Le-laser/Projet/rapports séances/Lucas Bagrowski/Avancement.md

### 10/09/2020

Prise de connaissance des différents projets <br/>
Choix du sujet -> Laser <br/>
Définition du groupe de travail <br/>
Répartition et définition des tâches <br/>
Choix des premiers actionneurs pour créer une tourelle 2 axes <br/>
Choix du laser pour prototype non dangereux <br/>
<br/> <br/>

### 25/09/2020

Choix des stepmotors Nema17<br/>
Création de la pièce 3D pour réaliser le lien entre les deux Stepmotors<br/>
Étude des ruches mises en place sur le campus <br/>
<br/> <br/>

### 08/10/2020

Fabrication carte électronique pour tourrelle 2 axes Stepmotors avec un PCB à trous <br/>
Création de la pièce 3D pour fixer la diode Laser de Mattéi sur l'axe d'un Stepmotor <br/>
Début du code pour tourelle 2 axes Stepmotors <br/>
<br/> <br/>

### 22/10/2020

Assemblage tourelle 2 axes Stepmotors avec pièce imprimée en 3D <br/>
Ajout de la diode Laser sur la tourelle <br/>
Fin du code tourelle 2 axes Stepmotors <br/>
Premiers tests de pointage laser sur un mur <br/>
<br/> <br/>

### 19/11/2020

Assemblage tourelle servomoteurs donnée par M. Peter <br/>
Début du code tourrelle 2 axes servomoteurs <br/>
Explication du fonctionnement de Kicad à Lucas Sabatier<br/>
<br/> <br/>

### 26/11/2020

Fin du programme servomoteur sur Arduino <br/>
Mesure de la précision des 2 différentes tourelles <br/>
Ré-impréssion de la pièce pour tourrelle Stepmotor, qui a cassé lors du transport <br/>
Création de la pièce 3D pour fixer la diode laser sur l'axe d'un servomoteur <br/>
<br/> <br/>

### 03/12/2020

Discussion concernant l'échange de données entre la partie acquisition d'image et la partie asservissement mécanique <br/>
Début du code d'asservissement sur un axe avec servo moteur <br/>
<br/> <br/>

### 04/12/2020

Fin du code d'asservissement sur un axe avec servo moteur <br/>
Premiers tests avec le clavier utilisé comme entrée d'information <br/>
<br/> <br/>

### 10/12/2020

Modélisation et impression du support Nema17 pour créer la platine fixe de tests <br/>
L'impression s'est mal déroulée, problème de sous extrusion <br/>
Ajout de la partie asservissement avec moteur pas à pas <br/>
<br/> <br/>

### 17/12/2020

Impression nouvelle pièce et assemblage <br/>
<br/> <br/>

### 08/01/2021

Diaporama de présentation du semestre 7 <br/>
<br/> <br/>

### 15/01/2021

Soutenance de mi-parcours <br/>
<br/> <br/>

### 29/01/2021

Début code communication entre les microcontroleurs UART<br/>
<br/> <br/>

### 12/02/2021

Récupération du code de Micha pour faire un prototype à positionner en conditions réelles mais<br/>
nous avons ensuite appris que les frelons ne sortaient pas avant Juin <br/>
<br/> <br/>

### 19/02/2021

Test et fin code communication entre les microcontroleurs <br/>
Création carte de prototypage pour le laser <br/>
<br/> <br/>

### 05/03/2021

Aide Mattéi sur le montage laser <br/>
<br/> <br/>

### 12/03/2021

Test Laser que Mattéi a fait fonctionner correctement sur la tourelle <br/>
<br/> <br/>

### 19/03/2021

Choix des composants <br/>
Import des librairies Kicad <br/>
Début schématique carte <br/>
<br/> <br/>

### 02/04/2021

Encore sur le schématique de la carte <br/>
Problèmes car certains systèmes ne sont pas encore définis <br/>
<br/> <br/>

### 15/04/2021

Préparation de la soutenance <br/>
<br/> <br/>
