Le-laser/Projet/rapports séances/Michael CHATOEV/suivi.md

### 10/09/2020
- Rédaction cahier des charges
- Etablissement d'une architecture système
- Définission des tâches
- Attribution des tâches

### 25/09/2020
- Recherches sur le machine learning
- Choix de l'outil utilisé pour le traitement d'image : tensorflow lite
- Installation Python 3.8.5 sur machine virtuelle linux
- Installation PIP sur machine virtuelle linux

### 08/10/2020
- Création d'une nouvelle VM dédiée à Tf
- Installation Tensorflow
- Installation Docker
- Installation PIP
- Découverte Colaboratory
- Introduction à Tf

### 22/10/2020
- Test de PyTorch : bibliothèque python pour le traitement d'image
- Installation de PyTorch
- Installation de PyCharm : IDE python
- Tutoriels PyTorch

Si PyTorch se trouve être trop compliqué ou ne convient pas à notre utilisation, nous passerons à TensorFlow.

### 19/11/2020
- Etude du contenu du Github https://github.com/Barrois/Detecteur-ESP32-Cam-Blob-Detector
- téléchargement et étude des librairies esp32_camera, esp_timer et arduinoFFT avec V.D. 

### 26/11/2020
- Etude du code du Github récupéré précédemment
- Une partie du code nécessite d'être reprise
- Création d'une fonction de transfert de données (Tx Rx) entre le ESP et un arduino pour envoyer les coordonnées du frelon
- Etude de la librairie JPEGDecoder

### 03/12/2020
- Traitement d'image

### 04/12/2020
- Traitement d'image
- Création code de test

### 26/11/2020
- Traitement d'image
- Création code photo+traitement

### 17/12/2020
- Traitement d'image
- Optimisation temps / espace du code de traitement d'image :
    - Masquage sur les tableaux de bools *gain de 7 bit/pixel
    - Modification de la logique de stockage des variables caractéristiques des tâches, *gain de 3xLEN/5 octets
    - Mesure du temps de traitement de l'image, 300.10^-6 sec pour une image de 50x50

### 08/01/2021
- Création powerpoint présentation de fin de semestre 7
- Création machine à état du système du projet

### 15/01/2021
- Soutenance

### 29/01/2021
- Traitement d'image

### 12/02/2021
- Création code automatisation de création d'images de test

### 19/02/2021
- Test traitement d'image Barrois

### 05/03/2021
- Test Traitement d'image perso

### 12/03/2021
- Optimisation traitement d'image perso

### 19/03/2021
- Reconnaissance frelon au micro

### 02/04/2021
- Code final esp32 reconnaissance frelon au micro + prise photo + envoie en UART

### 15/04/2021
- Création powerpoint présentation de fin de semestre 8
- Préparation soutenance
