Le-laser/Projet/Dossier Lucas/BOM_RucheV1.0.md

| Part Name| Ref| Value| Qtity on card| Qtity to buy| Link|
|-|-|:-:|:-:|:-:|-|
| Batteries Holder| 534-1043| 2 x 18650| 1| ?| [Link](https://www.mouser.fr/ProductDetail/Eagle-Plastic-Devices/12BHC186P-GR/?qs=AQlKX63v8Rv70Ee1H7gwgg%3D%3D)|
| Tension Regulator| 621-AP63300WU-7| Buck| 2| ?| [Link](https://www.mouser.fr/ProductDetail/Diodes-Incorporated/AP63300WU-7/?qs=bZr6mbWTK5nNNXnHDcrFZg%3D%3D)|
| Fusible réarmable| | | | | [Link]()|
| Diode anti inversion| 583-FML340A-W| 40V - 3A| 1| ?| [Link](https://www.mouser.fr/ProductDetail/Rectron/FML340A-W/?qs=5aG0NVq1C4znVqzNSkqGkQ%3D%3D)|
| Arduino Nano| | | | | [Link]()|
| ESP32 CAM| | | | | [Link]()|
| Drivers step motor| A4988| | | | [Link]()|
| Micro| MAX9814| | | | [Link]()|
| | | | | | [Link]()|
