Le-laser/Projet/Rapport de fabrication/READ ME

# Bzz_final : 
projet arduino à téleverser sur l'ESP32-CAM.

  A faire : 
*    Réception message de détection sonor d'un frelon par l'Arduino (UART)
*    Tests
