Le-laser/Projet/Rapport de fabrication/calculateur_composant_buck.xlsx

ILED: | 1 | A
Rsense: | 0.2 | Ohm
Selecting The Off-Time Setting Resistor
VLED: | 5 | V
Vdiode | 1 | V
DCRL: | 0.5 | Ohm
L: | 22 | uH
I ripple: | 100 | mA
tOFF: | 3.384615385e-07 | s
ROT: | 33846.15385 | Ohm
