Le-laser/Projet/Test_Img/img_test_1.txt

21 40 1 26 30 13
67	75	93	237	195	90	90	229	244	139	98	78	220	38	50	116	47	247	252	174	242	236	95	154	8	8	21	111	124	147	81	64	94	46	46	34	136	8	135	253	147	233	76	239	143	254	101	190	246	225	109	
233	206	205	132	86	85	153	197	81	173	23	145	12	70	63	174	78	199	54	76	218	160	153	203	48	24	176	111	15	146	220	248	224	42	252	55	127	22	252	81	195	147	226	208	217	162	254	41	106	53	
244	196	85	14	144	6	38	192	117	53	210	82	173	179	252	42	106	251	65	103	77	0	0	0	0	0	0	0	0	0	0	0	0	0	0	0	0	0	0	132	251	49	212	85	83	211	253	61	137	243	
2	94	2	19	100	168	211	217	93	39	172	12	218	41	181	70	37	118	45	115	251	0	0	0	0	0	0	0	0	0	0	0	0	0	0	0	0	0	0	41	36	80	127	119	37	252	180	46	240	54	
140	115	73	241	28	157	75	121	196	119	5	31	160	59	228	198	177	19	58	45	187	0	0	0	0	0	0	0	0	0	0	0	0	0	0	0	0	0	0	94	126	186	213	163	184	10	209	169	64	94	
156	10	207	184	167	28	178	108	147	55	11	53	114	240	123	164	4	181	209	63	20	0	0	0	0	0	0	0	0	0	0	0	0	0	0	0	0	0	0	80	250	105	115	179	242	69	220	51	36	122	
188	243	178	100	143	228	80	163	156	92	88	15	204	211	51	208	137	6	143	29	86	0	0	0	0	0	0	0	0	0	0	0	0	0	0	0	0	0	0	138	6	202	189	248	143	27	171	51	21	105	
167	199	205	55	45	158	218	201	122	51	88	71	134	140	151	16	18	39	172	104	50	0	0	0	0	0	0	0	0	0	0	0	0	0	0	0	0	0	0	178	178	239	171	194	11	215	245	32	65	157	
104	142	85	21	45	48	94	39	227	182	110	233	194	133	122	212	173	39	189	223	90	0	0	0	0	0	0	0	0	0	0	0	0	0	0	0	0	0	0	239	79	133	178	91	93	169	250	158	198	99	
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
190	114	214	190	35	240	167	25	163	18	24	177	76	225	232	175	200	72	227	66	21	168	190	82	10	87	184	54	97	8	21	32	122	107	95	29	220	134	182	0	152	206	177	101	48	154	21	249	98	120	
187	246	160	122	73	170	210	3	225	179	11	118	211	5	98	178	35	63	58	217	63	82	40	240	183	88	12	76	82	110	196	142	102	102	9	47	144	91	50	241	15	188	232	99	194	75	149	101	10	79	
190	73	162	230	185	90	190	197	167	145	180	108	32	27	82	168	201	99	5	124	212	147	57	189	118	123	136	13	96	146	92	31	219	126	133	22	217	69	91	129	214	16	109	246	170	64	159	117	35	36	
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
