Le-laser/Projet/Test_Img/img_test_2.txt

14 39 10 40 26 25
249	171	221	14	218	233	101	108	220	72	166	34	246	105	193	57	188	26	157	160	80	182	216	27	189	52	226	250	98	59	153	93	230	247	234	66	97	207	174	62	151	85	223	143	63	34	200	251	187	230	157	
12	29	118	40	218	42	138	86	141	197	239	106	173	103	85	111	201	165	30	135	61	115	231	204	50	10	22	47	197	252	76	82	153	66	122	117	109	5	75	250	75	186	228	120	35	185	231	108	95	6	
115	157	248	91	233	44	228	127	218	171	251	39	253	150	105	247	139	86	252	214	208	199	145	181	64	52	112	40	160	79	46	21	236	167	239	87	83	213	214	46	1	211	212	126	106	189	118	245	21	242	
204	229	187	221	28	251	19	140	37	51	219	210	199	73	249	184	32	77	14	246	123	15	74	80	141	52	15	131	42	163	118	118	9	177	212	37	46	231	49	83	27	141	165	227	86	160	28	118	109	42	
109	105	57	56	57	70	108	199	201	23	107	191	13	117	114	225	26	160	201	76	115	101	217	152	200	48	184	228	166	39	142	147	144	199	75	201	141	184	146	87	207	253	150	92	242	136	63	14	168	136	
90	155	237	179	53	54	99	237	154	137	21	41	156	165	112	232	239	253	161	130	212	240	0	108	77	243	116	12	129	30	149	91	185	3	15	110	58	241	93	84	123	241	126	24	152	238	1	8	109	34	
138	66	146	10	46	96	125	35	108	254	65	129	90	122	133	232	233	63	90	198	147	213	184	145	110	208	129	111	216	110	18	99	176	36	237	95	132	107	130	113	107	67	242	69	189	120	174	39	55	9	
237	203	95	167	93	205	120	94	188	82	204	206	53	253	243	162	93	247	15	95	105	249	162	93	190	223	85	236	135	141	118	244	216	213	156	181	163	149	148	223	103	97	175	28	95	35	191	60	154	206	
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
42	150	34	161	175	232	173	16	249	39	124	162	141	96	0	0	0	0	0	0	0	0	0	0	0	0	0	0	0	0	0	0	0	0	0	0	0	0	193	44	179	252	202	132	34	233	26	103	72	254	
103	44	138	17	153	180	40	60	213	215	37	3	231	159	0	0	0	0	0	0	0	0	0	0	0	0	0	0	0	0	0	0	0	0	0	0	0	0	43	101	66	184	69	5	100	249	2	174	253	163	
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
