Le-laser/Projet/Test_Img/img_test_3.txt

0 41 20 45 20 32
74	249	210	237	19	180	111	158	73	159	223	65	184	94	245	151	193	56	145	41	221	29	50	67	226	210	138	223	202	110	159	21	104	114	130	251	167	113	26	240	17	249	50	202	89	168	225	154	224	243	67	
190	144	118	130	242	200	13	210	148	123	241	41	99	228	172	95	140	30	122	125	175	243	47	249	204	215	91	104	56	79	171	247	224	161	249	83	107	7	166	0	2	152	41	101	125	85	69	137	243	63	
134	35	51	54	156	1	14	247	232	198	72	148	62	168	55	56	251	34	190	34	34	192	187	202	165	184	160	106	67	20	169	201	55	221	0	211	94	142	203	71	212	147	91	19	187	18	75	56	52	10	
90	86	74	149	161	111	79	66	218	18	86	132	91	13	225	219	224	64	233	44	7	190	64	99	209	251	117	156	52	170	166	143	128	240	37	161	96	243	99	186	6	185	64	225	70	161	189	166	226	167	
211	233	229	147	204	183	143	67	211	196	109	122	211	109	234	120	16	202	109	115	134	242	173	70	212	115	231	146	27	74	185	238	180	159	130	129	214	145	68	170	213	49	164	169	31	143	162	47	218	143	
34	224	130	79	39	215	195	142	233	222	89	164	77	14	195	79	15	155	224	211	197	55	5	107	96	36	122	3	210	212	146	117	181	149	196	92	109	8	107	87	102	196	123	179	210	64	130	97	91	227	
53	33	27	186	12	123	222	135	254	50	219	17	167	146	166	235	110	147	116	217	107	218	158	230	15	240	39	145	210	2	244	8	36	143	194	175	139	34	182	138	211	147	155	250	38	194	230	20	213	218	
238	65	182	13	41	197	254	207	214	209	210	76	89	118	219	29	38	103	190	221	241	146	113	14	141	23	80	243	43	38	79	153	104	6	167	145	75	166	224	161	247	179	237	81	42	202	237	81	50	44	
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
0	0	0	0	0	0	0	0	0	0	0	0	0	0	0	0	0	0	0	0	0	0	0	0	0	0	0	0	0	0	0	0	0	0	0	0	0	0	0	0	198	131	116	211	211	125	10	32	58	178	
0	0	0	0	0	0	0	0	0	0	0	0	0	0	0	0	0	0	0	0	0	0	0	0	0	0	0	0	0	0	0	0	0	0	0	0	0	0	0	0	194	248	246	198	151	94	229	148	169	126	
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
