Le-laser/Projet/Test_Img/img_test_4.txt

11 47 15 30 29 22
75	192	29	216	164	254	196	53	82	93	106	225	126	224	155	183	232	182	220	151	181	94	104	5	50	239	146	68	20	233	213	223	170	115	184	80	241	125	5	69	219	238	39	90	207	66	146	185	248	238	81	
174	204	57	51	127	168	70	195	189	48	154	29	219	141	213	171	127	211	48	196	175	31	107	137	238	173	155	40	38	139	121	212	88	50	136	215	219	206	156	25	254	182	54	90	68	139	6	195	95	54	
9	142	212	116	25	68	162	180	108	200	64	102	30	25	152	166	240	116	244	141	141	115	68	195	206	8	80	212	204	47	139	213	190	223	201	215	36	108	12	145	181	204	247	211	229	16	249	214	133	238	
228	19	98	168	87	49	177	39	134	253	86	145	211	148	113	29	108	22	138	248	167	64	197	31	147	171	47	141	2	52	251	230	199	94	16	31	16	193	197	22	191	155	39	19	49	24	48	29	46	58	
22	85	249	219	116	141	7	36	27	10	88	23	112	32	245	128	190	133	193	4	155	1	160	194	147	81	218	68	110	137	126	5	222	121	96	84	7	104	247	162	241	207	185	225	240	47	226	47	180	164	
52	207	38	84	18	185	165	237	253	147	119	125	152	213	118	249	169	252	225	161	159	83	114	217	53	226	9	24	18	190	61	197	142	99	26	161	29	63	15	155	83	6	152	235	219	15	101	134	12	198	
167	172	26	153	134	207	124	15	231	15	77	37	212	92	8	111	125	165	174	140	65	129	18	217	110	109	104	83	115	116	154	28	160	180	181	166	132	178	182	236	193	4	145	22	96	154	133	221	64	180	
233	1	54	123	218	36	233	194	247	220	182	146	120	88	71	174	126	76	97	180	57	162	57	74	184	153	228	63	247	164	115	97	165	169	221	0	206	71	194	198	36	249	89	157	82	32	76	80	235	45	
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
108	100	76	93	248	232	111	48	71	55	92	128	18	127	199	45	108	94	132	151	15	14	206	25	158	162	17	192	4	205	228	112	177	49	206	170	26	62	218	225	244	183	98	8	55	169	53	163	9	185	
186	24	72	137	176	102	44	194	39	48	16	12	33	193	188	239	109	87	173	199	57	162	127	155	42	54	197	222	89	78	25	21	229	224	158	151	71	75	217	110	250	233	249	28	171	182	139	152	14	184	
97	198	219	96	226	6	151	168	101	240	246	126	133	92	222	164	243	38	239	205	148	106	55	14	7	227	196	18	124	83	203	93	153	167	190	124	45	213	164	146	70	27	144	204	120	111	113	108	149	224	
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
