Le-laser/Projet/Test_Img/img_test_5.txt

11 43 3 26 27 14
126	242	108	38	223	1	106	186	54	173	226	119	114	214	61	116	43	44	103	45	189	251	177	20	253	13	190	114	52	179	82	178	38	62	216	6	63	195	65	244	113	36	108	99	250	41	215	166	85	63	83	
146	60	5	167	185	146	229	171	198	25	253	122	64	187	210	197	122	150	7	238	135	171	218	234	166	4	67	204	216	2	33	108	189	38	20	119	56	121	162	0	147	160	249	211	219	204	25	86	227	33	
69	107	204	32	214	242	163	153	192	125	155	97	233	90	135	125	81	64	246	244	191	10	21	185	221	241	6	119	199	105	152	14	85	228	173	44	87	82	69	151	207	224	248	57	186	1	54	140	65	45	
129	1	56	22	58	149	8	64	13	208	42	37	94	127	137	12	43	225	221	112	121	45	208	115	102	140	116	156	25	181	74	26	54	2	48	112	23	184	48	37	137	90	201	103	217	84	242	5	54	209	
244	47	254	198	162	229	210	150	2	107	76	0	0	0	0	0	0	0	0	0	0	0	0	0	0	0	0	0	0	0	0	0	0	0	0	0	0	0	0	0	0	0	76	133	130	78	181	114	102	237	
163	11	119	253	84	94	88	168	82	220	94	0	0	0	0	0	0	0	0	0	0	0	0	0	0	0	0	0	0	0	0	0	0	0	0	0	0	0	0	0	0	0	163	210	142	162	25	49	8	235	
200	11	87	148	87	220	151	38	18	10	12	0	0	0	0	0	0	0	0	0	0	0	0	0	0	0	0	0	0	0	0	0	0	0	0	0	0	0	0	0	0	0	1	45	150	247	44	234	214	4	
20	41	224	114	76	51	1	238	76	178	119	0	0	0	0	0	0	0	0	0	0	0	0	0	0	0	0	0	0	0	0	0	0	0	0	0	0	0	0	0	0	0	56	250	130	15	15	89	235	166	
127	126	49	11	254	94	33	118	10	13	77	0	0	0	0	0	0	0	0	0	0	0	0	0	0	0	0	0	0	0	0	0	0	0	0	0	0	0	0	0	0	0	14	160	245	111	19	66	162	148	
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
160	207	205	101	21	174	44	206	35	110	132	53	231	221	219	218	162	152	101	236	60	207	220	120	44	122	130	132	39	161	29	72	113	234	173	134	25	217	212	187	72	89	112	175	182	77	10	89	101	112	
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
