Le-laser/Projet/Test_Img/img_test_6.txt

18 35 8 33 26 20
110	4	240	47	61	179	26	25	157	252	116	143	183	202	76	20	31	164	205	233	240	37	76	47	224	154	213	217	208	133	189	190	9	174	237	70	226	136	95	0	5	84	143	60	31	92	81	63	1	158	41	
114	195	244	161	36	15	246	126	95	124	60	31	6	235	140	76	78	148	44	78	154	0	94	214	158	186	167	93	187	70	7	46	10	251	79	174	139	70	45	234	67	105	137	73	212	150	21	162	43	192	
241	69	192	80	156	223	11	68	61	70	139	68	244	21	192	68	195	203	11	112	182	205	218	192	23	47	214	171	210	2	109	68	199	173	148	100	13	31	168	75	228	179	15	217	201	207	158	13	27	41	
126	82	246	216	19	14	135	233	57	90	107	38	30	51	212	178	23	225	81	192	172	55	243	188	144	189	12	47	75	40	88	73	122	79	34	13	220	169	118	150	132	97	188	162	149	17	213	44	243	39	
108	32	94	97	92	239	31	232	158	233	17	119	51	11	198	212	151	36	127	14	186	131	111	119	38	132	137	123	49	252	163	157	156	129	254	249	240	158	226	16	136	115	135	60	253	205	17	149	113	144	
35	44	147	18	36	58	23	45	181	72	169	216	229	70	218	101	191	75	4	162	91	140	149	98	200	147	49	218	168	162	234	75	79	127	221	242	57	244	32	238	188	201	72	34	143	35	135	80	110	139	
114	202	152	136	45	224	155	221	59	196	1	166	16	80	165	109	67	222	225	226	77	158	172	149	65	187	184	200	12	40	212	254	114	236	135	31	77	35	125	137	103	126	175	120	206	85	229	145	179	72	
116	1	230	160	151	167	92	80	240	232	247	197	103	233	50	238	10	127	145	135	136	249	133	56	241	84	13	87	101	192	159	89	66	7	249	217	174	213	169	159	190	162	228	38	140	150	148	22	23	166	
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
1	227	66	47	217	121	237	108	135	63	182	229	117	77	171	48	231	26	130	25	72	21	243	218	174	95	30	201	160	28	89	33	127	155	81	90	148	190	70	29	125	124	130	114	201	46	163	50	200	38	
75	17	186	191	235	105	31	138	179	191	38	13	97	165	40	50	127	188	240	198	89	110	67	220	97	141	138	5	191	83	170	138	227	229	74	80	206	106	218	2	169	1	15	138	38	182	188	166	243	173	
236	204	156	175	169	125	61	180	130	124	135	172	135	108	146	209	188	98	187	151	100	229	24	243	112	189	42	46	227	30	91	208	235	119	1	21	244	189	201	246	59	209	164	194	62	182	20	250	25	208	
18	253	182	169	113	166	103	27	212	76	58	176	156	165	40	157	58	157	92	132	148	23	86	57	89	148	240	109	15	137	189	160	7	243	74	247	155	49	20	239	252	205	160	154	242	201	183	45	103	147	
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
