Le-laser/Projet/Test_Img/img_test_8.txt

22 42 8 45 32 26
142	62	136	153	46	33	192	4	119	198	104	43	123	232	206	240	166	244	111	109	28	60	139	207	140	7	167	223	222	152	174	236	215	182	134	133	216	72	137	80	142	113	250	11	90	201	123	1	62	234	237	
218	39	121	170	179	1	209	19	223	107	65	205	194	248	84	199	81	28	208	33	43	194	28	181	29	102	49	158	36	28	12	254	194	134	42	245	135	251	10	230	230	202	180	41	195	137	240	21	37	66	
54	80	5	210	6	161	184	55	191	220	210	76	92	149	210	134	140	217	130	22	192	233	224	245	19	165	127	132	58	36	70	240	117	202	195	250	235	124	51	172	216	6	248	53	28	75	187	168	164	190	
190	228	168	159	218	59	196	217	63	127	254	133	112	243	80	179	238	61	48	161	105	136	40	225	190	68	45	249	108	81	184	43	54	224	74	145	156	16	107	219	15	233	98	127	93	178	51	204	111	226	
110	216	107	22	186	169	217	103	164	70	184	220	113	239	62	60	1	218	76	108	54	218	214	152	90	179	203	13	128	59	111	111	21	90	133	79	5	96	183	41	38	112	133	24	223	195	84	224	30	32	
205	85	250	164	237	85	88	185	225	89	117	81	200	10	43	78	89	48	46	17	216	85	130	95	109	98	35	65	195	66	97	145	23	92	181	5	49	141	63	19	230	180	227	175	62	15	126	151	191	44	
169	152	1	44	119	110	14	155	47	209	93	144	226	116	236	152	248	30	39	183	176	14	235	20	62	42	36	188	194	99	104	108	123	106	24	243	88	165	15	136	247	235	25	218	223	7	116	216	164	27	
145	86	168	252	233	230	40	14	35	234	240	140	214	109	246	238	224	79	20	239	215	12	91	113	231	59	120	219	20	156	118	37	114	31	35	93	134	202	234	41	181	220	53	12	201	171	122	42	251	142	
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
20	246	243	73	66	243	196	229	128	43	225	204	72	184	134	164	212	1	183	63	78	168	0	0	0	0	0	0	0	0	0	0	0	0	0	0	0	0	0	0	0	70	69	60	26	118	18	145	133	244	
37	251	104	238	62	219	179	36	220	94	7	169	166	63	175	202	147	176	3	82	127	43	0	0	0	0	0	0	0	0	0	0	0	0	0	0	0	0	0	0	0	153	196	230	51	59	249	69	64	110	
106	60	86	216	122	177	12	31	142	106	38	56	145	228	104	219	121	152	222	203	24	138	0	0	0	0	0	0	0	0	0	0	0	0	0	0	0	0	0	0	0	228	220	113	152	152	234	221	88	216	
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
