Le-laser/Projet/Test_Img/img_test_9.txt

11 30 15 49 20 32
152	23	59	242	43	118	205	218	58	103	174	68	135	62	44	70	155	117	5	225	222	57	253	123	8	253	5	86	239	72	215	8	96	146	123	11	9	73	229	194	48	20	134	55	82	50	126	109	168	3	80	
135	187	205	3	195	203	135	27	59	80	114	68	176	5	191	59	15	136	33	209	57	53	89	112	7	139	110	117	52	240	197	60	172	147	63	240	223	71	12	27	151	253	222	199	3	30	3	145	39	163	
100	96	88	61	80	95	72	63	84	252	48	153	57	221	173	247	206	141	63	90	40	86	88	8	157	218	165	32	109	204	195	81	172	155	14	253	251	86	61	207	83	109	106	140	202	24	133	153	37	68	
115	77	155	203	212	184	39	123	217	148	72	29	101	245	185	115	115	53	201	48	5	30	157	238	42	232	7	175	130	44	116	246	249	16	66	206	72	105	74	34	125	19	191	226	136	121	213	251	46	160	
44	51	62	73	35	104	50	169	152	53	86	13	171	80	156	109	31	228	87	233	135	212	252	71	56	133	192	14	1	110	46	172	161	108	117	68	85	168	110	109	93	196	122	136	21	150	245	179	123	77	
157	3	162	26	74	90	159	138	104	32	248	23	204	27	3	67	222	88	107	77	69	72	18	191	208	166	86	70	91	82	148	120	212	182	147	159	17	178	42	248	211	163	16	32	62	20	99	29	235	78	
107	50	150	252	113	230	164	72	46	0	26	66	247	238	248	139	142	137	63	57	130	146	220	19	178	27	166	23	183	18	228	162	68	124	160	54	99	69	253	145	196	24	211	188	7	76	200	22	213	8	
79	89	154	171	235	77	70	146	227	253	164	201	161	105	197	66	159	41	7	29	59	75	53	142	135	187	219	80	209	177	215	160	138	241	76	118	191	146	136	163	145	46	236	178	23	178	116	54	92	250	
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
106	196	40	4	36	158	29	159	225	229	89	0	0	0	0	0	0	0	0	0	0	0	0	0	0	0	0	0	0	187	83	18	86	142	48	20	6	221	233	74	214	203	50	59	106	80	66	22	253	172	
90	165	49	127	68	205	31	165	52	120	97	0	0	0	0	0	0	0	0	0	0	0	0	0	0	0	0	0	0	135	10	183	149	58	203	156	25	182	230	111	2	152	42	108	232	109	3	102	26	93	
140	202	220	80	153	123	246	205	116	215	212	0	0	0	0	0	0	0	0	0	0	0	0	0	0	0	0	0	0	253	144	107	57	219	8	209	18	110	192	20	134	107	1	238	216	4	212	114	97	97	
189	190	178	87	185	41	37	46	1	249	45	0	0	0	0	0	0	0	0	0	0	0	0	0	0	0	0	0	0	145	101	229	237	236	183	0	218	247	148	97	99	149	207	187	25	165	174	249	7	108	
56	57	67	242	98	104	33	100	225	78	117	0	0	0	0	0	0	0	0	0	0	0	0	0	0	0	0	0	0	199	179	99	180	234	227	16	227	120	240	198	141	193	131	38	103	177	32	237	157	89	
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
