Le-laser/Projet/Rapport de fabrication/Ruche_V1.0/Projet_ruche_V1.0/Projet_ruche_V1.0.kicad_pcb

## KiCad design schematics/schematic.sch

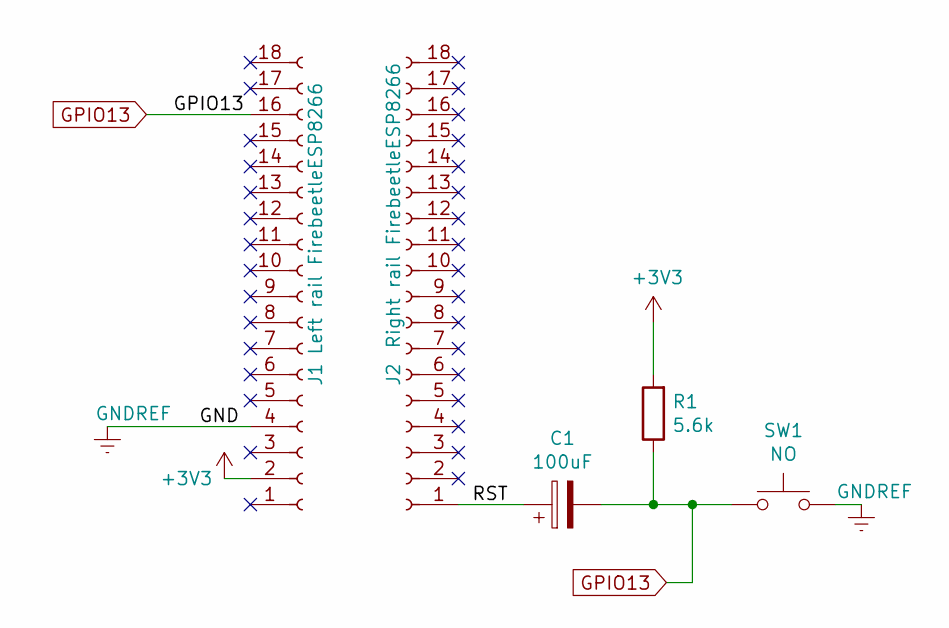
[picture p38: schematic schematic.sch]

Parts:
C1: 100uF
J1: Left rail FirebeetleESP8266
J2: Right rail FirebeetleESP8266
R1: 5.6k
SW1: NO

Connections:
+3V3: J1.2, R1.2
GNDREF: J1.4, SW1.2
GPIO13: C1.2, J1.16, R1.1, SW1.1
RST: C1.1, J2.1
