Le-laser/Projet/(commit log)

2020-09-10 Create Note de début de projet
2020-09-10 Create Cahier des charges.md
2020-12-09 Add files via upload
    copier la sortie du .ino dans l'excel et appuyer sur le bouton pour visualiser l'image grayscale
    [trait_img.xlsm]
2020-12-09 Add files via upload
    copier la sortie du .ino dans l'excel et appuyer sur le bouton pour voir l'image
    attention, la taille de l'image est définie en brute dans la macro vba (range)
    [trait_img.xlsm]
2021-01-14 Update fft_to_csv.pde
    corrigé erreur a la ligne 130 :
    if (amp[3] > (0.66* (amp[2]+ amp[3])))
    passe à
    if (amp[3] > (0.66* (amp[2]+ amp[4])))
    [fft_to_csv.pde]
2021-05-23 Create Rapport de fabrication
